JacksonRussett/UTAT_flightsystems/Test Board/Rough sketch - Aug 28.JPG

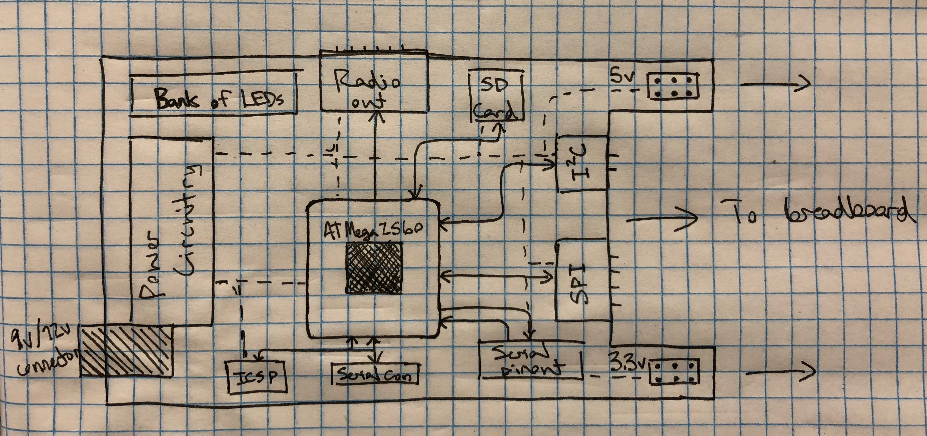
Test Board/Rough sketch - Aug 28.JPG
