JacksonRussett/UTAT_flightsystems/README.md

# UTAT_flightsystems

Github repository for the development of telemetry systems to be used in hybrid/solid rocket launches.
