JacksonRussett/UTAT_flightsystems/CAD/Avionics Bay/Avionics Bay June 2019/README.txt

Suffixes for the files:

function suffixes:
(part) - part to be integrated with another part to make the full printable version
(rep) - a CAD representation of a physical part of the bay that will not be printed
(assembly) - assembly of parts for visualization but not to print
<no suffix> - a final part version

printability suffixes:
(p) - printable and print ready
(nrtp) - will be printable but is currently not ready to print
(dnp) - do not print, not a printable file
