JacksonRussett/UTAT_flightsystems/CAD/MountingPlan_June2019.pptx

0.188’’

5.12’’

0.188’’

0.201’’

1.80’’

0.370’’

0.811’’

Radio Mount

StratoLogger Mount

0.654’’

2.76’’

PCB Mount

1.97’’

1.69’’

0.469’’

0.654’’

0.370’’

0.201’’

1.89’’
