JacksonRussett/UTAT_flightsystems/PCB/BlockDiagram_v1.pptx

To recovery
system actuation

Stratologgers

To radio
transmitter

Main Bay v2.1 – Flight Systems Board
Flight critical recovery actuation accomplished by flight computers (Stratologgers). All telemetry data (GPS, IMU, Pressure, and Stratologger info) collected and stored by microcontroller onto micro SD card.

Serial Devices

COMP2

COMP1

Reset
Button

Serial
Programmer

Sensors

Inertial Measurement Unit

Barometric Pressure Sensor

Two Wire interface

Storage

uSD Card Slot

SPI interface

Microcontroller
(ATMega2560 Breakout)

Serial Interface

Neo-6M GPS Module
