JacksonRussett/UTAT_flightsystems/PCB/MainBay_v2.2/Schematics/MicrocontrollerBase.pdf

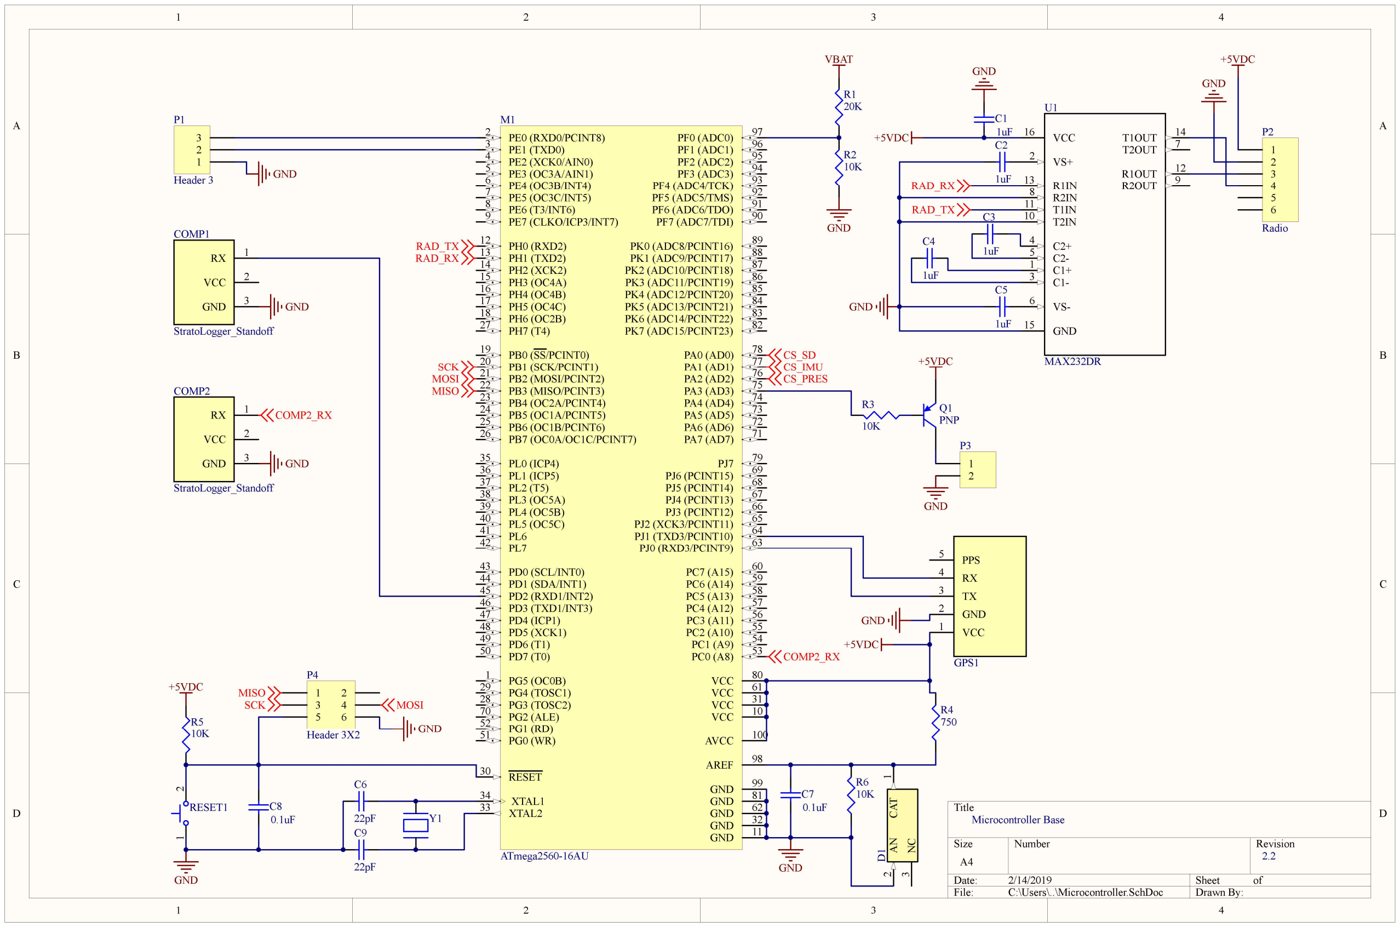
[picture p3: page 1]

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
Title

Size | Number | | Revision
A4
Date: | 2/14/2019 | Sheet | of
File: | C:\Users\..\Microcontroller.SchDoc | Drawn By:
PJ0 (RXD3/PCINT9) | 63
AVCC | 100
VCC | 31
GND | 11 GND | 32
GND | 81

PG5 (OC0B) 1

PD2 (RXD1/INT2) 45

RESET 30

PA4 (AD4) | 74
PA7 (AD7) | 71
PA5 (AD5) | 73
VCC | 80

XTAL1 34

PC1 (A9) | 54 PC2 (A10) | 55 PC3 (A11) | 56 PC4 (A12) | 57 PC5 (A13) | 58
PJ5 (PCINT14) | 68 PJ6 (PCINT15) | 69
AREF | 98

PD1 (SDA/INT1) 44

PB6 (OC1B/PCINT6) 25

PD3 (TXD1/INT3) 46
PD4 (ICP1) 47
PD5 (XCK1) 48
PD6 (T1) 49
PD7 (T0) 50
PF1 (ADC1) | 96
PF2 (ADC2) | 95
PC0 (A8) | 53
PA3 (AD3) | 75
PF4 (ADC4/TCK) | 93
PF5 (ADC5/TMS) | 92
PF6 (ADC6/TDO) | 91
PF7 (ADC7/TDI) | 90
PG0 (WR) 51 | PG1 (RD) 52 | PG2 (ALE) 70
PA6 (AD6) | 72

PD0 (SCL/INT0) 43

PH2 (XCK2) 14

PL2 (T5) 37
PL3 (OC5A) 38
PL4 (OC5B) 39
PL5 (OC5C) 40
PL6 41

VCC 10

XTAL2 33

PG3 (TOSC2) 28

PB5 (OC1A/PCINT5) 24

PF3 (ADC3) | 94
PA1 (AD1) | 77
PA2 (AD2) | 76

PE4 (OC3B/INT4) 6
PE5 (OC3C/INT5) 7
PE6 (T3/INT6) 8
PE7 (CLKO/ICP3/INT7) 9
PJ3 (PCINT12) | 66
PK5 (ADC13/PCINT21) | 84 PK4 (ADC12/PCINT20) | 85 PK3 (ADC11/PCINT19) | 86

PB2 (MOSI/PCINT2) 21
PB3 (MISO/PCINT3) 22
PB4 (OC2A/PCINT4) 23
PA0 (AD0) | 78
GND | 99
PK2 (ADC10/PCINT18) | 87
PJ2 (XCK3/PCINT11) | 65
PJ1 (TXD3/PCINT10) | 64

PG4 (TOSC1) 29

PF0 (ADC0) 97

PE3 (OC3A/AIN1) 5

PE2 (XCK0/AIN0) 4

PE1 (TXD0) 3

PE0 (RXD0/PCINT8) 2

PB7 (OC0A/OC1C/PCINT7) 26

PB1 (SCK/PCINT1) 20 PB0 (SS/PCINT0) 19

PH1 (TXD2) 13

PJ7 | 79
PJ4 (PCINT13) | 67
GND | 62
VCC | 61

PL7 42

PH0 (RXD2) 12

PH3 (OC4A) 15
PH4 (OC4B) 16
PH5 (OC4C) 17
PH6 (OC2B) 18
PH7 (T4) 27 | PK6 (ADC14/PCINT22) | 83
PK1 (ADC9/PCINT17) | 88 PK0 (ADC8/PCINT16) | 89

PL0 (ICP4) 35

PK7 (ADC15/PCINT23) 82

PL1 (ICP5) 36

PC6 (A14) | 59 PC7 (A15) | 60

M1

ATmega2560-16AU ² ¹
RESET1

GND

10K

R5

GND

Microcontroller Base

2.2

22pF | Y1

C6

22pF

C9 | CAT

# 1 NC

### 3 AN

### 2 D1

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
VBAT

GND

GND

MOSI
MISO

SCK

GND

GND

VCC | 2
GND | 3
RX | 1

COMP1

StratoLogger_Standoff

VCC | 2
GND | 3
RX | 1

COMP2

StratoLogger_Standoff

VCC 1

GND 2

TX 3

RX 4

PPS 5

GPS1

+5VDC

GND

GND

+5VDC

CS_PRES

CS_IMU

0.1uF

C8

CS_SD

RAD_RX

RAD_TX

1
2
3
4
5
6

P2

Radio

R2OUT | 9
R1OUT | 12
T2OUT | 7
T1OUT | 14

GND 15

VS- 6

C1- 3

C1+ 1

C2- 5

C2+ 4

T2IN 10 | T1IN 11 | R2IN 8

R1IN 13

VS+ 2

VCC 16

U1

MAX232DR

+5VDC

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
RAD_TX

RAD_RX

COMP2_RX

COMP2_RX | Q1 PNP

1
2

P3

GND

+5VDC

10K

R3

+5VDC
SCK | MOSI

MISO

0.1uF

C7

1 2
3 4
5 6

P4

Header 3X2 | GND

1

2

3

P1

Header 3
