JacksonRussett/UTAT_flightsystems/PCB/MainBay_v2.2/Schematics/Sensors.pdf

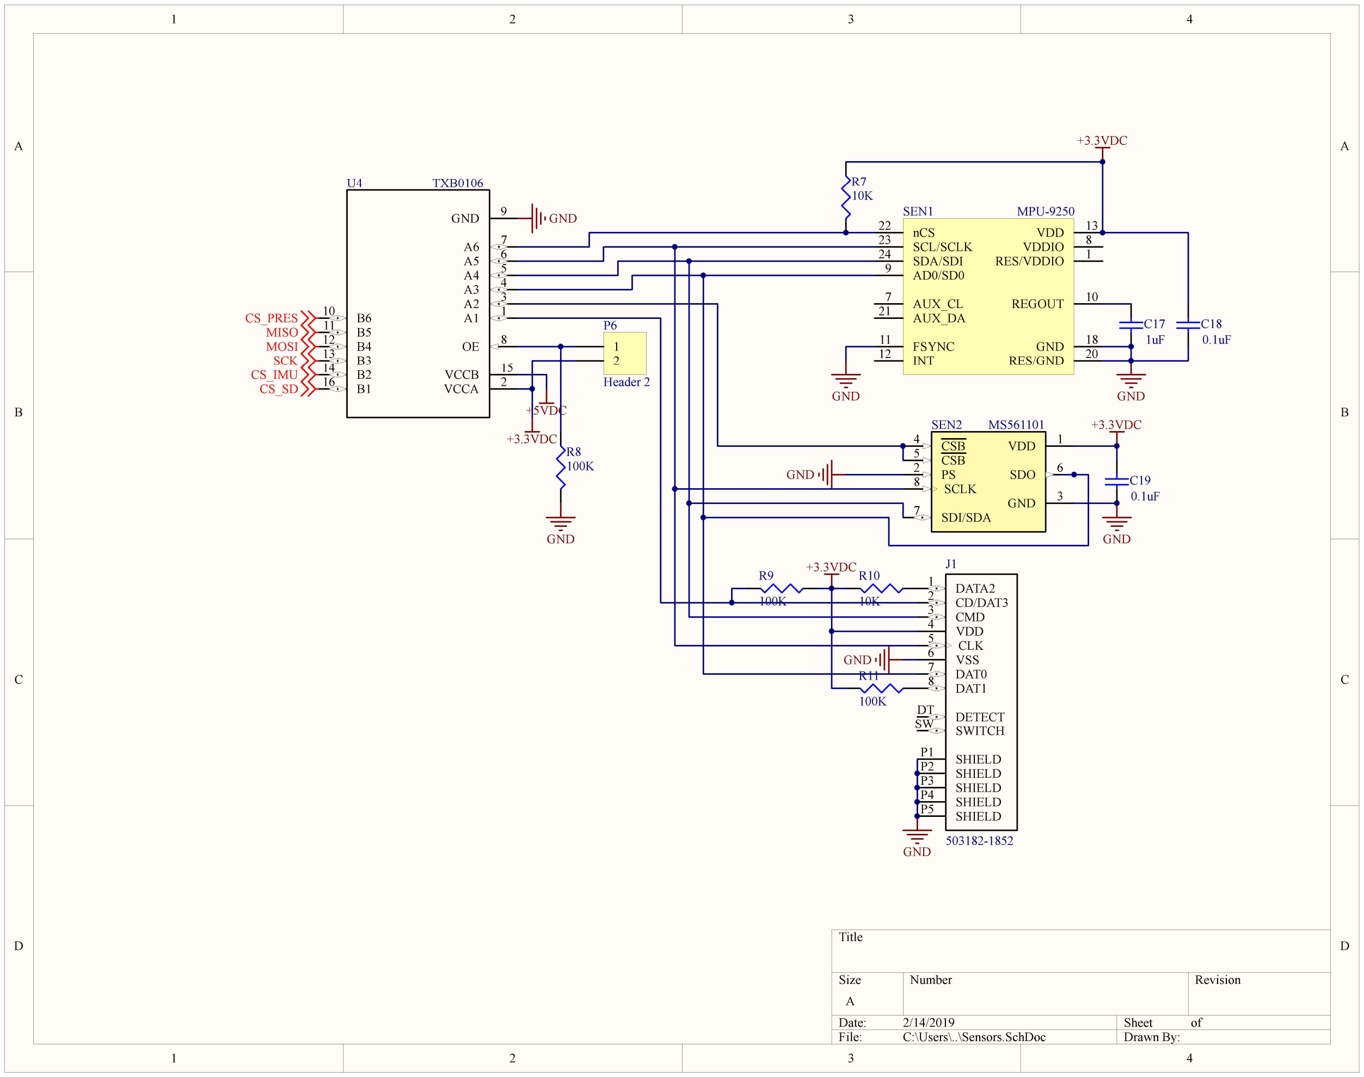
[picture p4: page 1]

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
Title

Size | Number | | Revision
A
Date: | 2/14/2019 | Sheet | of
File: | C:\Users\..\Sensors.SchDoc | Drawn By:
RES/VDDIO | 1

AUX_CL 7

VDDIO 8

AD0/SD0 9

REGOUT 10

FSYNC 11
INT 12
VDD | 13
GND | 18
RES/GND | 20

AUX_DA 21

nCS 22
SCL/SCLK 23
SDA/SDI 24
SEN1 | MPU-9250
GND | 3
SDO | 6
VDD | 1

SDI/SDA 7

SCLK 8

PS 2

CSB 5

CSB 4

SEN2 MS561101

+3.3VDC

GND

1uF

C17

GND

+3.3VDC

B6 10
B5 11
B4 12
B3 13
B2 14
B1 16
GND | 9
A6 | 7
A5 | 6
A4 | 5
A3 | 4
A2 | 3
A1 | 1
OE | 8
VCCB | 15
VCCA | 2
U4 | TXB0106

GND

+3.3VDC

GND
0.1uF

C19

SHIELD P5 | SHIELD P4 | SHIELD P3 | SHIELD P2 | SHIELD P1
SWITCH SW | DETECT DT

DAT1 8

DAT0 7

VSS 6

CLK 5

VDD 4

CMD 3

CD/DAT3 2

DATA2 1

J1

503182-1852

MOSI

MISO

CS_IMU

SCK

CS_PRES

GND

GND

GND

+3.3VDC

CS_SD

10K

R10

100K

R11

100K

R9

10K

R7

0.1uF

C18
1
2

P6

Header 2

+5VDC

100K

R8

GND
