JacksonRussett/UTAT_flightsystems/PCB/MainBay_v2.2/VoltRef.png

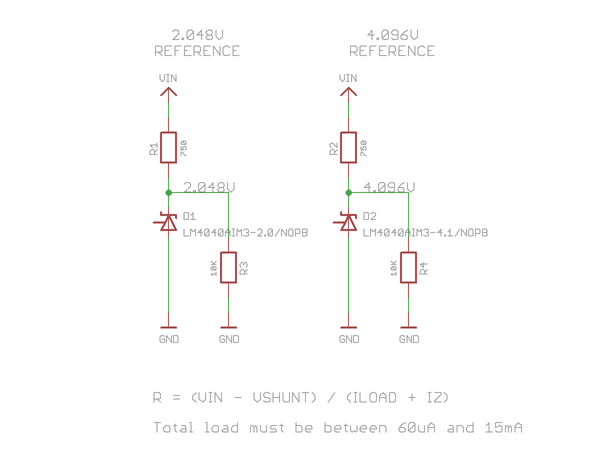
PCB/MainBay_v2.2/VoltRef.png
