JacksonRussett/UTAT_flightsystems/Reference Documents/PowerSchematic.PNG

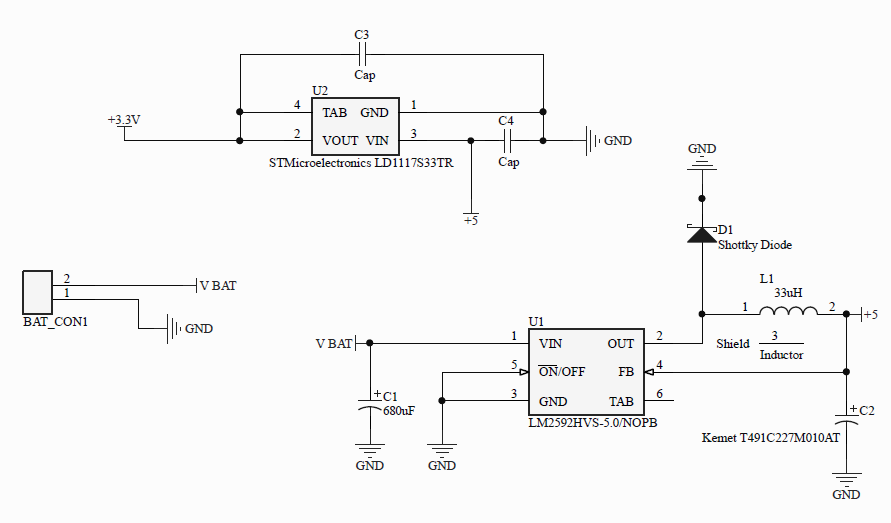
Reference Documents/PowerSchematic.PNG
