JacksonRussett/UTAT_flightsystems/PCB/Flight Systems Bill of Materials.xlsx

Sheet: v2.1
Flight Systems v2.1
Part Code | Class | Name | Details | Supplier | Weight (g) | 507.03 | Price: | $424.99 | Link
M1 | Active | Microcontroller | Arduino ATMega2560 "naked" | Fuzzystudios | 5.50 |  | $21.91 |  | https://www.tindie.com/products/FuzzyStudio/naked-mega-an-arduino-mega-2560-compatible-board/
COMP1 | Active | Flight Computer | Stratologger CF | Perfectflite | 25.60 |  | $93.10 |  | http://www.perfectflite.com/SLCF.html
COMP2 | Active | Flight Computer | Stratologger CF | Perfectflite | 25.60 |  | $93.10 |  | http://www.perfectflite.com/SLCF.html
SEN1 | Active | IMU Sensor | SparkFun IMU Breakout - MPU-9250 | Sparkfun | 0.99 |  | $18.40 |  | https://www.sparkfun.com/products/13762?_ga=2.125612810.101642581.1510585709-120728623.1510585709
SEN2 | Active | Pressure Transducer | CSG Shop - MS5611-01BA03 | CSG Shop | 0.56 |  | $29.99 |  | http://www.csgshop.com/product.php?id_product=96
MEM1 | Active | MicroSD Memory | MicroSD card breakout board+ | Sparkfun | 2.20 |  | $4.95 |  | https://www.sparkfun.com/products/13743
SD1 | Active | SD Card | SanDisk Micro SD | TBD | 0.50 |  | $22.59
BOARD | Active | PCB board | Flight Avionics Board | JLCBCB | 51.76 |  | Not included here |  | (weight estimate): https://www.leiton.de/leiton-tools-weight-calculation.html
GPS1 | Active | GPS Chip | Neo-6M GPS | Hobbyking | 13.00 |  | $38.45 |  | https://www.robotshop.com/en/u-blox-neo-6m-gps-receiver-module.html
CON1 | Connector | Recovery Connector | CONCR-140108 | Creatron Inc. | 5.00 |  | $7.50 |  | https://www.creatroninc.com/product/8-pin-circular-connector-set-panel-mount/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
USBTTL | External | USB to TTL Serial Converter | CP2102 USB 2.0 to TTL Serial Converter | Fuzzystudios | 0.00 |  | $5.35 |  | https://www.tindie.com/products/FuzzyStudio/cp2102-usb-20-to-ttl-serial-converter/
RADIO1 | External | Radio | RF4463PRO Radio Transmitter | Sketch AliExpress Vendor | 47.00 |  | Not included here |  | https://www.aliexpress.com/item/2pcs-SV652-433MHz-RS232-Interface-500mW-Industrial-Class-3km-Distance-Long-Distance-Wireless-Transceiver-Module/32391760503.ht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
BT1 | External | Main LiPo battery | 5000mAH 2S 15C | Pulse Battery | 217.00 |  | $41.59 |  | https://www.pulsebattery.com/pulse-5000mah-2s-7-4v-15c-receiver-battery-lipo-battery.html
BT2 | External | Battery | 9 volt | Walmart | 45.00 |  | Not included here
BT3 | External | Battery | 9 volt | Walmart | 45.00 |  | Not included here
SWITCH1 | External | RBF Switch | Subminiature Snap-Acting Switches | McMaster Carr | 6.20 |  | $5.97 |  | https://www.mcmaster.com/#catalog/124/965/=1c3z74q
SWITCH2 | External | RBF Switch | Subminiature Snap-Acting Switches | McMaster Carr | 6.20 |  | $5.97 |  | https://www.mcmaster.com/#catalog/124/965/=1c3z74q
SWITCH3 | External | RBF Switch | Subminiature Snap-Acting Switches | McMaster Carr | 6.20 |  | $5.97 |  | https://www.mcmaster.com/#catalog/124/965/=1c3z74q
C1 | Passive | Capacitor | 1uF Ceramic - 490-5860-1-ND | Digikey | 0.03 |  | $0.48 |  | https://www.digikey.ca/product-detail/en/murata-electronics-north-america/GRM31MR71E105KA01L/490-5860-1-ND/3029181
C2 | Passive | Capacitor | 100pF Ceramic - 490-4290-1-ND | Digikey | 0.03 |  | $0.52 |  | https://www.digikey.ca/product-detail/en/murata-electronics-north-america/GRM31A7U2J101JW31D/490-4290-1-ND/1022668
C3 | Passive | Capacitor | 680uF Electrolytic - P19725CT-ND | Digikey | 0.03 |  | $1.36 |  | https://www.digikey.ca/product-detail/en/panasonic-electronic-components/EEU-FM1V681B/P19725CT-ND/6109623
C4 | Passive | Capacitor | 10uF - 493-13313-1-ND | Digikey | 0.03 |  | $1.22 |  | https://www.digikey.ca/product-detail/en/nichicon/UCY2G100MPD1TD/493-13313-1-ND/4333047
C5 | Passive | Capacitor | 1uF Ceramic - 490-5860-1-ND | Digikey | 0.03 |  | $0.48 |  | https://www.digikey.ca/product-detail/en/murata-electronics-north-america/GRM31MR71E105KA01L/490-5860-1-ND/3029181
D1 | Passive | Diode | Shottky Diode - B140B-FDICT-ND | Digikey | 0.09 |  | $0.38 |  | https://www.digikey.ca/product-detail/en/diodes-incorporated/B140B-13-F/B140B-FDICT-ND/804889
L1 | Passive | Inductor | 33uH - 445-9568-1-ND | Digikey | 1.30 |  | $1.64 |  | https://www.digikey.ca/product-detail/en/tdk-corporation/CLF10040T-330M/445-9568-1-ND/3909741
R1 | Passive | Resistor | 10K Ohms - P10KDACT-ND | Digikey | 0.01 |  | $0.54 |  | https://www.digikey.ca/product-detail/en/panasonic-electronic-components/ERA-6AEB103V/P10KDACT-ND/1465971
R2 | Passive | Resistor | 1M Ohms - P1MDACT-ND | Digikey | 0.01 |  | $0.54 |  | https://www.digikey.ca/product-detail/en/panasonic-electronic-components/ERA-6AEB105V/P1MDACT-ND/1466019
R3 | Passive | Resistor | 100K Ohns - P100KDACT-ND | Digikey | 0.01 |  | $0.54 |  | https://www.digikey.ca/product-detail/en/panasonic-electronic-components/ERA-6AEB104V/P100KDACT-ND/1465995
R4 | Passive | Resistor | 1M Ohms - P1MDACT-ND | Digikey | 0.01 |  | $0.54 |  | https://www.digikey.ca/product-detail/en/panasonic-electronic-components/ERA-6AEB105V/P1MDACT-ND/1466019
R5 | Passive | Resistor | 100K Ohns - P100KDACT-ND | Digikey | 0.01 |  | $0.54 |  | https://www.digikey.ca/product-detail/en/panasonic-electronic-components/ERA-6AEB104V/P100KDACT-ND/1465995
RESET | Passive | Tactile Button | 401-1097-1-ND | Digikey | 0.12 |  | $1.03 |  | https://www.digikey.ca/product-detail/en/c-k/KSS221GLFS/401-1097-1-ND/417665
U1 | Passive | Buck Converter | LM2592HVSX-5.0/NOPBCT-ND | Digikey | 1.40 |  | $9.93 |  | https://www.digikey.ca/product-detail/en/texas-instruments/LM2592HVSX-5.0-NOPB/LM2592HVSX-5.0-NOPBCT-ND/3526872
U2 | Passive | Voltage Regulator | LD1117S33TR | Digikey | 0.60 |  | $9.53 |  | https://www.digikey.ca/product-detail/en/stmicroelectronics/LD1117S33TR/497-1242-1-ND/586242
Q1 | Passive | PNP Transistor for camera | ZXTP19020DFFCT-ND | Digikey | 0.01 |  | $0.88 |  | https://www.digikey.ca/product-detail/en/diodes-incorporated/ZXTP19020DFFTA/ZXTP19020DFFCT-ND/1557785

Sheet: v2.2
Flight Systems v2.2
Part Code | Class | Name | Details | Supplier | Weight (g) | 387.09 | Price: | $123.82 | Link
M1 | Active | Microcontroller | Arduino ATMega2560-16AU | Digikey |  |  | $18.62
COMP1 | Active | Flight Computer | Stratologger CF | Perfectflite | 25.60 |  | Already Bought |  | http://www.perfectflite.com/SLCF.html | http://www.perfectflite.com/SLCF.html | http://www.perfectflite.com/SLCF.html | http://www.perfectflite.com/SLCF.html | http://www.perfectflite.com/SLCF.html | http://www.perfectflite.com/SLCF.html | http://www.perfectflite.com/SLCF.html
COMP2 | Active | Flight Computer | Stratologger CF | Perfectflite | 25.60 |  | Already Bought |  | http://www.perfectflite.com/SLCF.html | http://www.perfectflite.com/SLCF.html | http://www.perfectflite.com/SLCF.html | http://www.perfectflite.com/SLCF.html | http://www.perfectflite.com/SLCF.html | http://www.perfectflite.com/SLCF.html | http://www.perfectflite.com/SLCF.html
SEN1 | Active | IMU Sensor | MPU-9250 | Mouser |  |  | $12.86 |  | https://www.mouser.ca/ProductDetail/TDK-InvenSense/MPU-9250
SEN2 | Active | Pressure Transducer | MS5611-01BA03 | Digikey |  |  | $18.82
SD1 | Active | MicroSD Memory | MicroSD card Slot | Mouser |  |  | $4.46 |  | https://www.mouser.ca/ProductDetail/Molex/503182-1853
- | Active | SD Card | SanDisk Micro SD |  |  |  | Already Bought
BOARD | Active | PCB board | Flight Avionics Board | JLCBCB | 51.76
GPS1 | Active | GPS Chip | Neo-6M GPS | Hobbyking | 13.00 |  | $38.45
CON1 | Connector | Recovery Connector | CONCR-140108 | Creatron Inc. | 5.00 |  | Already Bought
USBTTL | External | USB to TTL Serial Converter | CP2102 USB 2.0 to TTL Serial Converter | Fuzzystudios | 0.00 |  | Already Bought
RADIO1 | External | Radio | RF4463PRO Radio Transmitter | Sketch AliExpress Vendor | 47.00 |  | Already Bought
BT1 | External | Main LiPo battery | 5000mAH 2S 15C | Pulse Battery | 217.00 |  | Already Bought
SWITCH1 | External | RBF Switch | Subminiature Snap-Acting Switches | Mouser |  |  | $2.53 |  | https://www.mouser.ca/ProductDetail/Omron-Electronics/SS-5GL13?qs=nNiD76Ca0%252bv0XsO8fhViMQ==
SWITCH2 | External | RBF Switch | Subminiature Snap-Acting Switches | Mouser |  |  | $2.53 |  | https://www.mouser.ca/ProductDetail/Omron-Electronics/SS-5GL13?qs=nNiD76Ca0%252bv0XsO8fhViMQ==
SWITCH3 | External | RBF Switch | Subminiature Snap-Acting Switches | Mouser |  |  | $2.53 |  | https://www.mouser.ca/ProductDetail/Omron-Electronics/SS-5GL13?qs=nNiD76Ca0%252bv0XsO8fhViMQ==
RESET | Passive | Tactile Button | 401-1097-1-ND | Digikey | 0.12 |  | $1.03 |  | https://www.digikey.ca/product-detail/en/c-k/KSS221GLFS/401-1097-1-ND/417665
U1 | Active | Buck Converter | LM2592HVSX-5.0/NOPBCT-ND | Digikey | 1.40 |  | $9.93 |  | https://www.digikey.ca/product-detail/en/texas-instruments/LM2592HVSX-5.0-NOPB/LM2592HVSX-5.0-NOPBCT-ND/3526872
U2 | Active | Voltage Regulator | LD1117S33TR | Digikey | 0.60 |  | $9.53 |  | https://www.digikey.ca/product-detail/en/stmicroelectronics/LD1117S33TR/497-1242-1-ND/586242
U3 | Passive | Level SHifting | TXB0106 | Digikey
Q1 | Passive | PNP Transistor for camera | ZXTP19020DFFCT-ND | Digikey | 0.01 |  | $0.88 |  | https://www.digikey.ca/product-detail/en/diodes-incorporated/ZXTP19020DFFTA/ZXTP19020DFFCT-ND/1557785
C3 | Passive | Capacitor | 680uF Electrolytic | Home Hardware
C4 | Passive | Capacitor | 10uF Electrolytic | Home Hardware
BAT1 | Connector | XT30 battery connector |  | AliExpress |  |  | $1.65 |  | https://www.aliexpress.com/item/2Pairs-AMASS-XT30PW-Banana-golden-XT30-Upgrade-Right-Angle-Plug-Connector-male-female-ESC-Motor-PCB/32910350989.html

Sheet: Power Supply v1
Power Supply v1
Part Code | Class | Name | Details | Supplier | Weight (g) | 3.58 | Quantity | Price: | $62.53 | Links
U1 | Active | Buck Converter | Fixed 5 Volts - LM2592HVSX-5.0/NOPBCT-ND | Digikey | 1.40 |  | 2 | $19.86 |  | https://www.digikey.ca/product-detail/en/texas-instruments/LM2592HVSX-5.0-NOPB/LM2592HVSX-5.0-NOPBCT-ND/3526872
U2 | Active | Voltage Regulator | Fixed 3.3 Volts - LD1117S33TR | Digikey | 0.60 |  | 2 | $19.06 |  | https://www.digikey.ca/product-detail/en/stmicroelectronics/LD1117S33TR/497-1242-1-ND/586242
L1 | Passive | Inductor | 33uH - 445-9568-1-ND | Digikey | 1.30 |  | 5 | $8.20 |  | https://www.digikey.ca/product-detail/en/tdk-corporation/CLF10040T-330M/445-9568-1-ND/3909741
D1 | Passive | Diode | Shottky Diode - B140B-FDICT-ND | Digikey | 0.09 |  | 5 | $1.90 |  | https://www.digikey.ca/product-detail/en/diodes-incorporated/B140B-13-F/B140B-FDICT-ND/804889
?1 | Passive | Fuse | Glass Fuse (5A) - 5MF 5-R | Digikey | 0.09 |  | 5 | $0.21 |  | https://www.digikey.com/product-detail/en/bel-fuse-inc/5MF-5-R/507-1269-ND/1009041
?1 | Mount | Fuse | Fuse Holders - 01110501Z | Digikey | 0.10 |  | 10 | $1.90 |  | https://www.digikey.ca/product-detail/en/littelfuse-inc/01110501Z/F4189-ND/2518598
U3 | Active | Comparator | TPS3700DDCR | Digikey |  |  | 4 | $11.40 |  | https://www.digikey.ca/product-detail/en/texas-instruments/TPS3700DDCR/296-30395-1-ND/3250123
