JacksonRussett/UTAT_flightsystems/CAD/Avionics Bay/Avionics Bay June 2019/Frame/Frame.SLDPRT

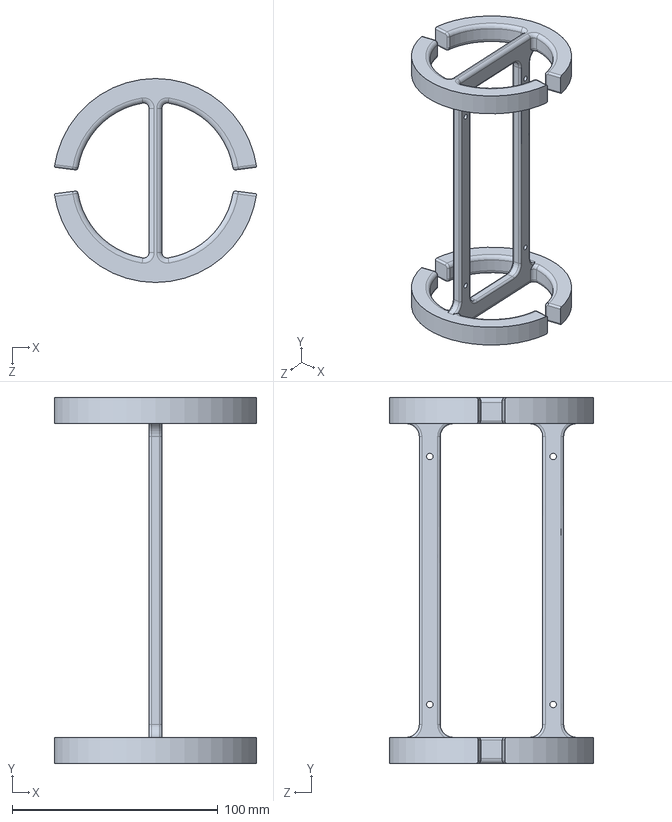
[picture p7: CAD file, 2019-06-23]
CAD/Avionics Bay/Avionics Bay June 2019/Frame/Frame.SLDPRT
98.2 x 177.8 x 99.1 mm
