JacksonRussett/UTAT_flightsystems/CAD/Avionics Bay/Avionics Bay June 2019/Radio/Radio_Mount.SLDPRT

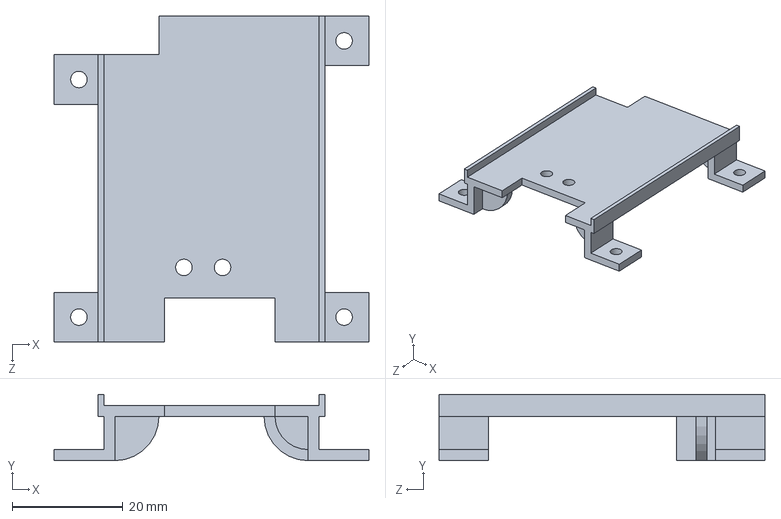
[picture p8: CAD file, 2019-06-23]
CAD/Avionics Bay/Avionics Bay June 2019/Radio/Radio_Mount.SLDPRT
57.0 x 12.0 x 59.0 mm
