JacksonRussett/UTAT_flightsystems/CAD/Avionics Bay/Avionics Bay June 2019/20190406_AvionicsFramePlate (assembly) (dnp).SLDASM

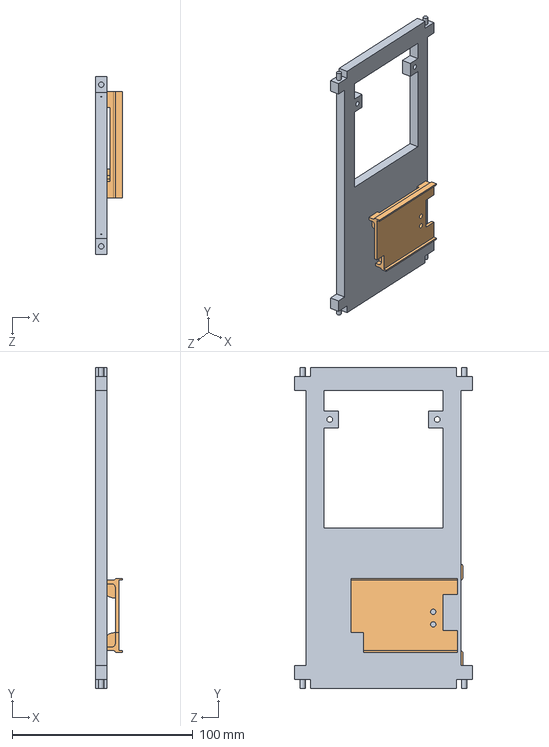
[picture p9: CAD file, 2019-06-23]
CAD/Avionics Bay/Avionics Bay June 2019/20190406_AvionicsFramePlate (assembly) (dnp).SLDASM
15.0 x 177.8 x 98.9 mm
20190312_AvionicsFramePlate (part) (dnp)
20190330_RadioMount (nrtp)
