JacksonRussett/UTAT_flightsystems/CAD/Avionics Bay/Avionics Bay June 2019/20190406_AvionicsFrameBasesRBF (assembly) (dnp).SLDASM

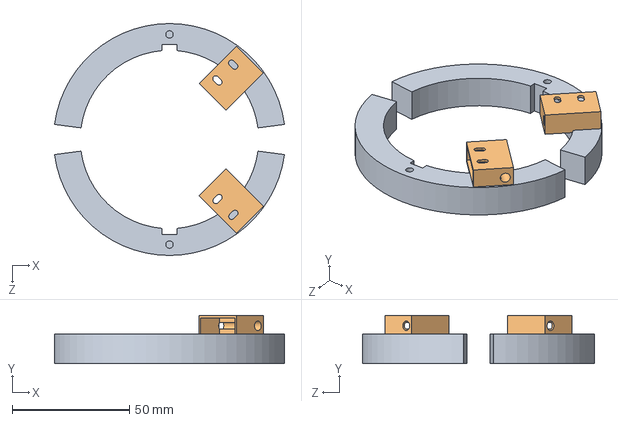
[picture p10: CAD file, 2019-06-23]
CAD/Avionics Bay/Avionics Bay June 2019/20190406_AvionicsFrameBasesRBF (assembly) (dnp).SLDASM
98.2 x 20.6 x 99.0 mm
20190330_AvionicsFrameBases (nrtp) x 2
20190312_RBFHolder (part) (dnp) x 2
