JacksonRussett/UTAT_flightsystems/CAD/20190504_L2_Avionics_Rails-p.sldprt

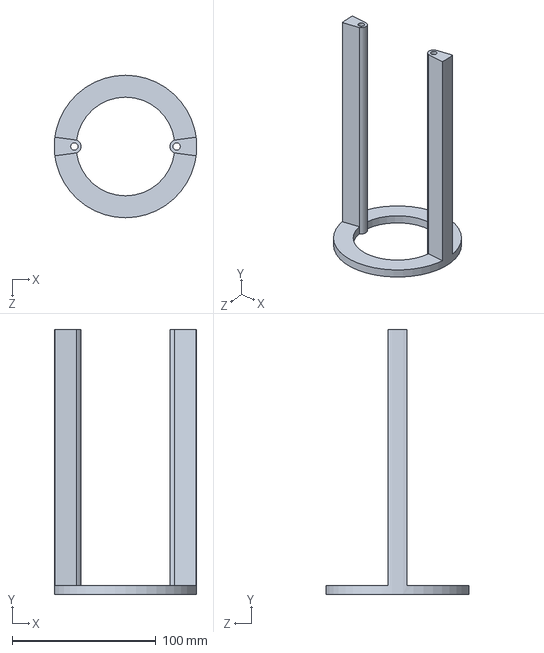
[picture p11: CAD file, 2019-06-23]
CAD/20190504_L2_Avionics_Rails-p.sldprt
98.8 x 184.1 x 99.1 mm
