JacksonRussett/UTAT_flightsystems/CAD/Avionics Bay/Avionics Bay June 2019/20180727_Avionics_frame2.STL

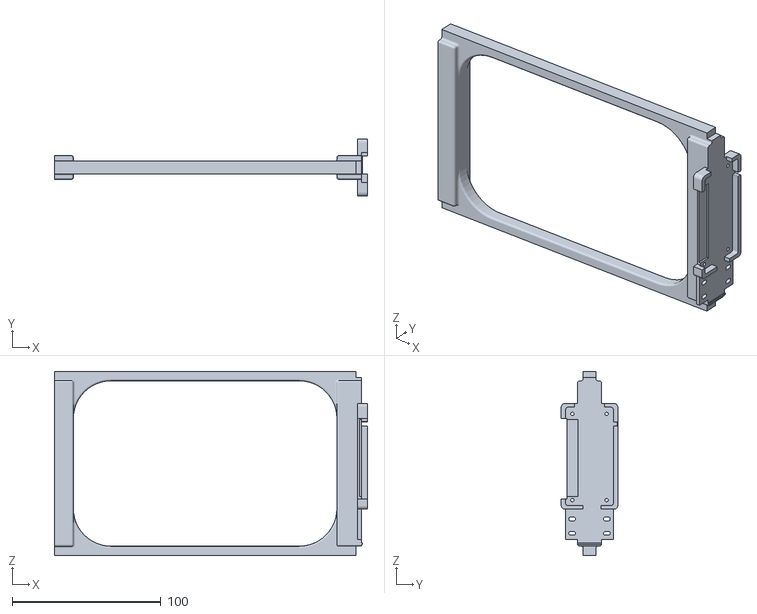
[picture p12: CAD file, 2019-06-23]
CAD/Avionics Bay/Avionics Bay June 2019/20180727_Avionics_frame2.STL
210.6 x 38.1 x 124.0
