JacksonRussett/UTAT_flightsystems/CAD/20190506_L2_AvionicsFramePlate-p.sldprt

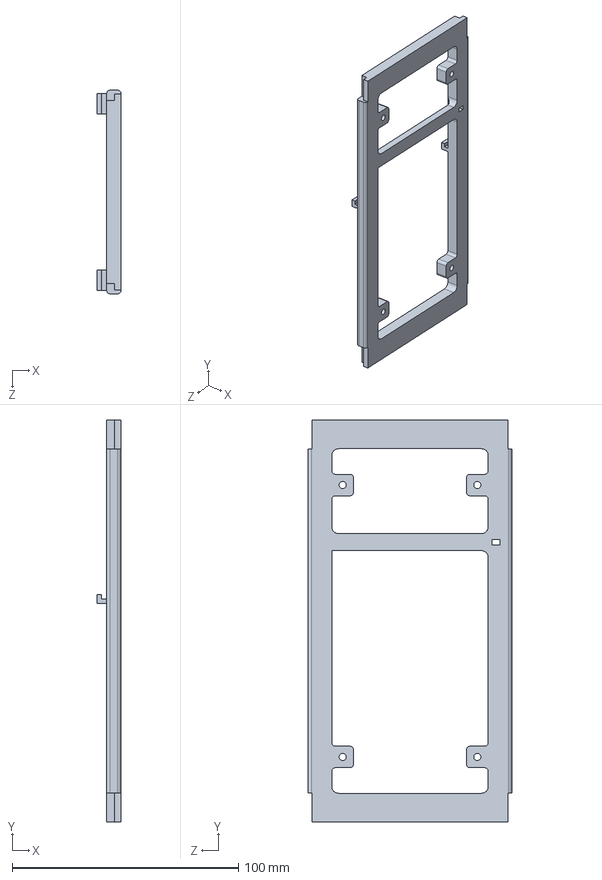
[picture p13: CAD file, 2019-06-23]
CAD/20190506_L2_AvionicsFramePlate-p.sldprt
10.6 x 177.8 x 90.1 mm
