JacksonRussett/UTAT_flightsystems/CAD/20190506_L2_AvionicsFrameBasesRBF-p.sldprt

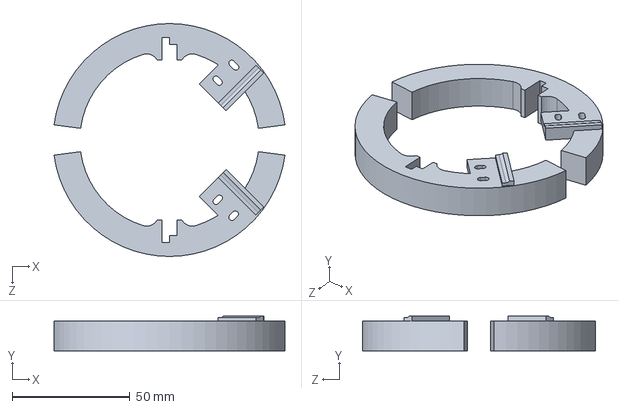
[picture p14: CAD file, 2019-06-23]
CAD/20190506_L2_AvionicsFrameBasesRBF-p.sldprt
98.2 x 14.7 x 99.0 mm
