JacksonRussett/UTAT_flightsystems/CAD/Avionics Bay/Avionics Bay June 2019/20190330_BatteryCrib (nrtp).SLDPRT

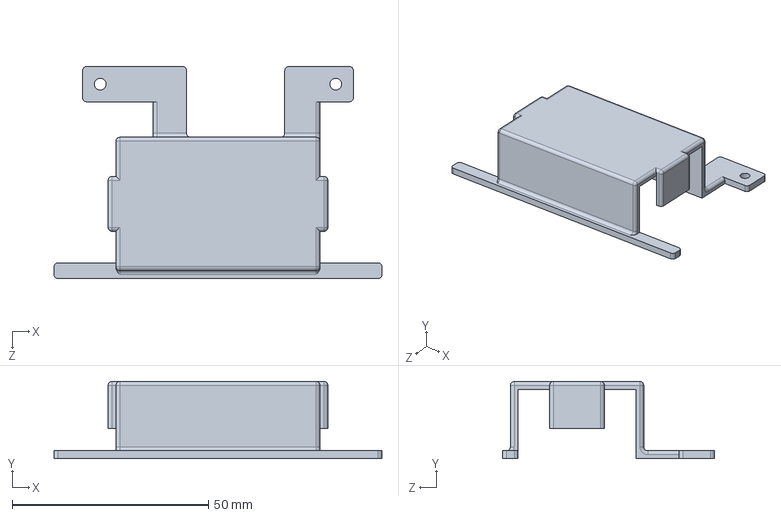
[picture p15: CAD file, 2019-06-23]
CAD/Avionics Bay/Avionics Bay June 2019/20190330_BatteryCrib (nrtp).SLDPRT
83.6 x 19.6 x 54.0 mm
