JacksonRussett/UTAT_flightsystems/CAD/Avionics Bay/Avionics Bay June 2019/20190406_AvionicsFrameBasesRBF (nrtp).SLDPRT

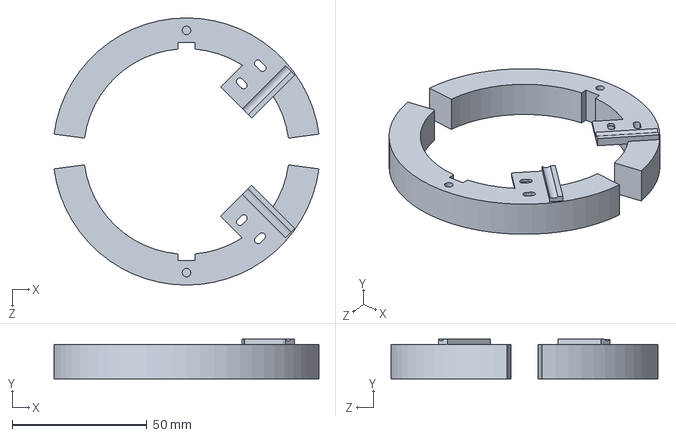
[picture p16: CAD file, 2019-06-23]
CAD/Avionics Bay/Avionics Bay June 2019/20190406_AvionicsFrameBasesRBF (nrtp).SLDPRT
98.2 x 14.7 x 99.0 mm
