JacksonRussett/UTAT_flightsystems/CAD/Avionics Bay/Avionics Bay June 2019/20190504_L2_AvionicsFramePlate (p).SLDPRT

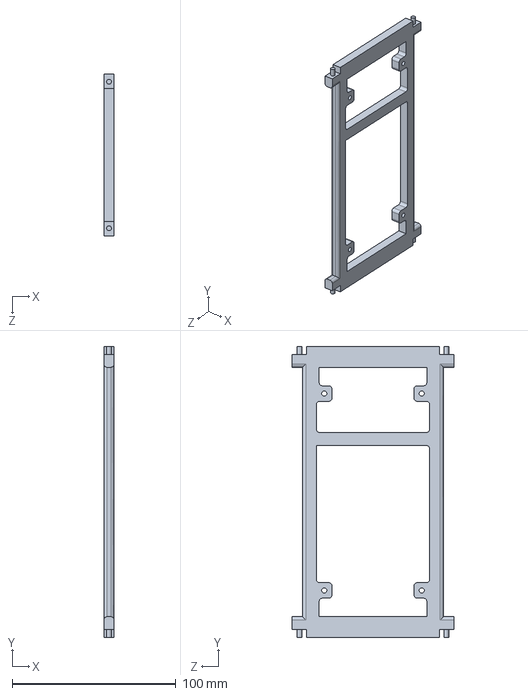
[picture p17: CAD file, 2019-06-23]
CAD/Avionics Bay/Avionics Bay June 2019/20190504_L2_AvionicsFramePlate (p).SLDPRT
6.35 x 177.8 x 99.0 mm
