JacksonRussett/UTAT_flightsystems/CAD/Avionics Bay/Avionics Bay June 2019/20190330_AvionicsFrameBases (nrtp).SLDPRT

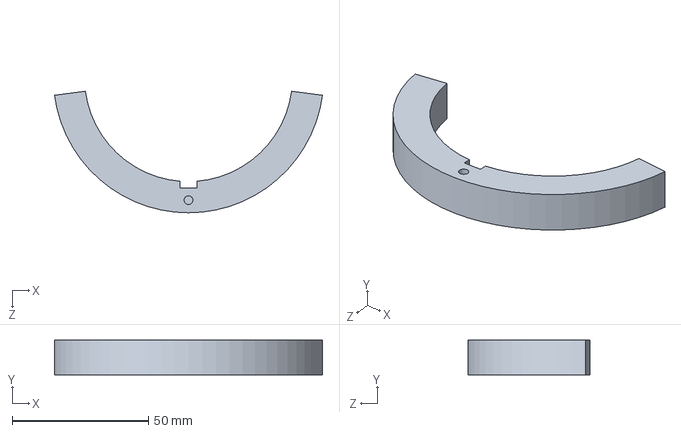
[picture p18: CAD file, 2019-06-23]
CAD/Avionics Bay/Avionics Bay June 2019/20190330_AvionicsFrameBases (nrtp).SLDPRT
98.2 x 12.7 x 44.6 mm
