JacksonRussett/UTAT_flightsystems/CAD/Avionics Bay/Avionics Bay June 2019/20190406_AvionicsFramePlate (nrtp).SLDPRT

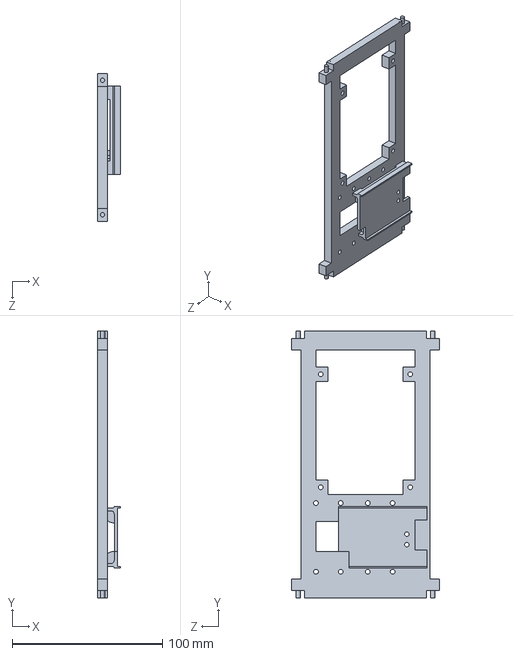
[picture p19: CAD file, 2019-06-23]
CAD/Avionics Bay/Avionics Bay June 2019/20190406_AvionicsFramePlate (nrtp).SLDPRT
15.0 x 177.8 x 98.9 mm
