JacksonRussett/UTAT_flightsystems/CAD/Avionics Bay/Avionics Bay June 2019/20190312_Radio (rep) (dnp).SLDPRT

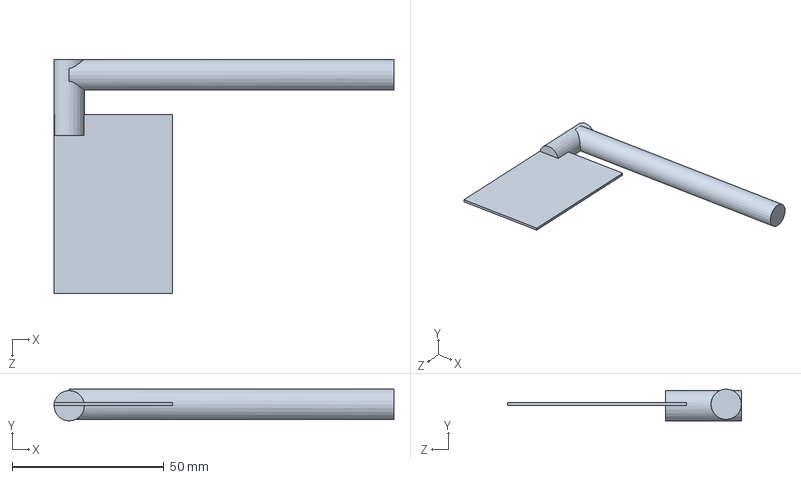
[picture p20: CAD file, 2019-06-23]
CAD/Avionics Bay/Avionics Bay June 2019/20190312_Radio (rep) (dnp).SLDPRT
112.0 x 10.5 x 77.0 mm
