JacksonRussett/UTAT_flightsystems/CAD/Avionics Bay/Avionics Bay June 2019/20190316_StratoLoggers.SLDPRT

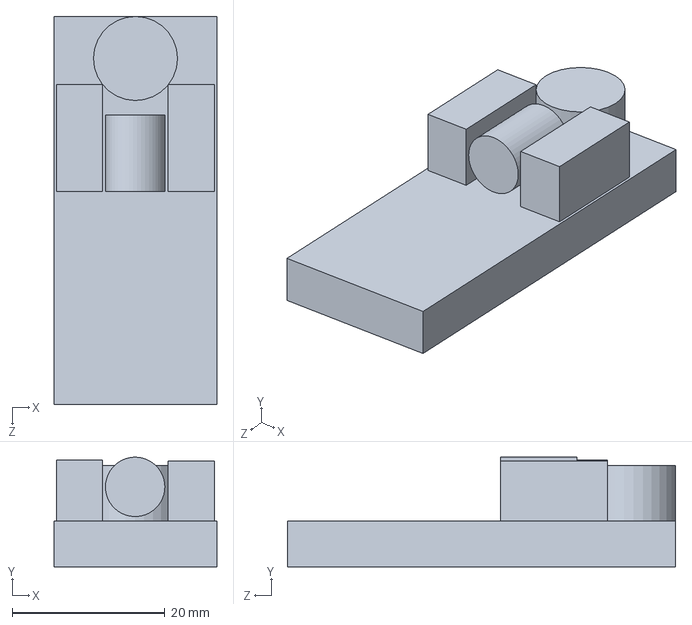
[picture p21: CAD file, 2019-06-23]
CAD/Avionics Bay/Avionics Bay June 2019/20190316_StratoLoggers.SLDPRT
21.3 x 14.3 x 50.8 mm
