JacksonRussett/UTAT_flightsystems/CAD/Avionics Bay/Avionics Bay June 2019/20190312_AvionicsFramePlate (part) (dnp).SLDPRT

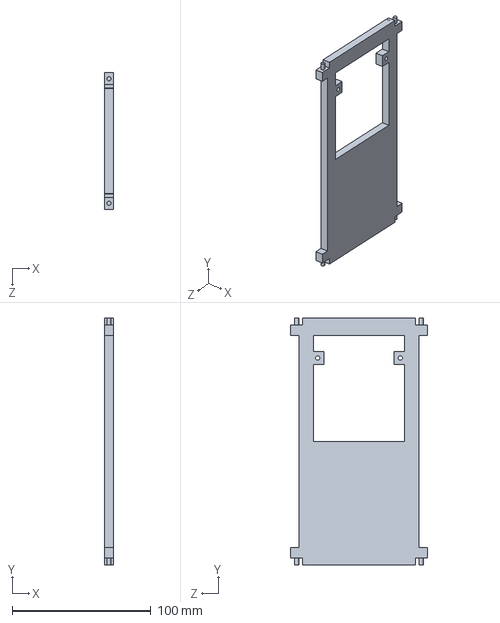
[picture p22: CAD file, 2019-06-23]
CAD/Avionics Bay/Avionics Bay June 2019/20190312_AvionicsFramePlate (part) (dnp).SLDPRT
6.35 x 177.8 x 98.9 mm
