JacksonRussett/UTAT_flightsystems/CAD/Avionics Bay/Avionics Bay June 2019/20190312_RBFHolder (part) (dnp).SLDPRT

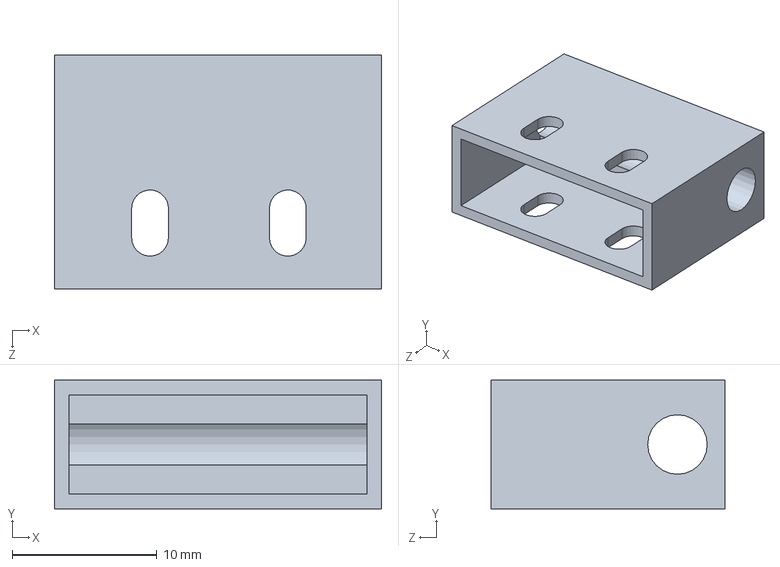
[picture p23: CAD file, 2019-06-23]
CAD/Avionics Bay/Avionics Bay June 2019/20190312_RBFHolder (part) (dnp).SLDPRT
22.6 x 8.89 x 16.2 mm
