JacksonRussett/UTAT_flightsystems/(list of files, cad)

Other CAD files:
CAD/Avionics Bay/Avionics Bay June 2019/20190330_RadioMount (nrtp).SLDPRT
CAD/Avionics Bay/Avionics Bay June 2019/20190504_L2_AvionicsFrameBasesRBF (p).SLDPRT
