JacksonRussett/UTAT_flightsystems/Test Board/Dev Board Dimensions.pptx

4mm

120mm

10mm

4mm

d = 4mm

16mm

56mm

36mm
