JacksonRussett/UTAT_flightsystems/Code/Flight Code/L2_Nov2019/test.csv

Time | Pressure | Temperatue | Altitude | Current | Voltage | AccelX | AccelY | AccelZ | GyroX | GyroY | GyroZ | Latitude | Longitude
14.082598 | 1023.700012 | 21.799999 | -88.376160 | 187.699997 | 7.390760 | -0.732663 | 10.257283 | 0.033521 | 0.032607 | 0.013588 | 0.005605 | nan | nan
8372580.000000 | 1023.609985 | 21.820000 | -87.625595 | 187.399994 | 7.391830 | -0.287319 | 10.367422 | 0.474076 | 0.052048 | -0.000527 | 0.040493 | nan | nan
8435081.000000 | 1023.530029 | 21.840000 | -86.958923 | 715.400024 | 7.258700 | -0.354360 | 10.319535 | 0.081407 | 0.047121 | -0.025828 | 0.042756 | nan | nan
8497581.000000 | 1023.479980 | 21.820000 | -86.532303 | 711.099976 | 7.238580 | -0.062252 | 10.300381 | 0.167603 | 0.024218 | -0.024896 | 0.047284 | nan | nan
8560081.000000 | 1023.530029 | 21.840000 | -86.958923 | 702.400024 | 7.254301 | 0.110139 | 10.314747 | -0.311262 | 0.060970 | -0.034350 | 0.051811 | nan | nan
8622581.000000 | 1023.609985 | 21.820000 | -87.625595 | 702.200012 | 7.243061 | -0.004789 | 10.309958 | -0.047886 | 0.006907 | -0.026893 | 0.040892 | nan | nan
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
