JacksonRussett/UTAT_flightsystems/Test Board/DevBoardDim.PNG

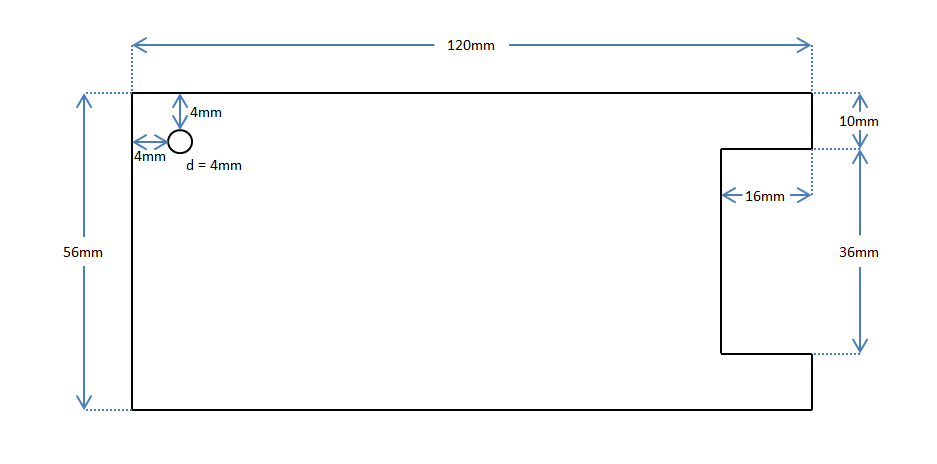
Test Board/DevBoardDim.PNG
