JacksonRussett/UTAT_flightsystems/Test Board/Power Unit.jpg

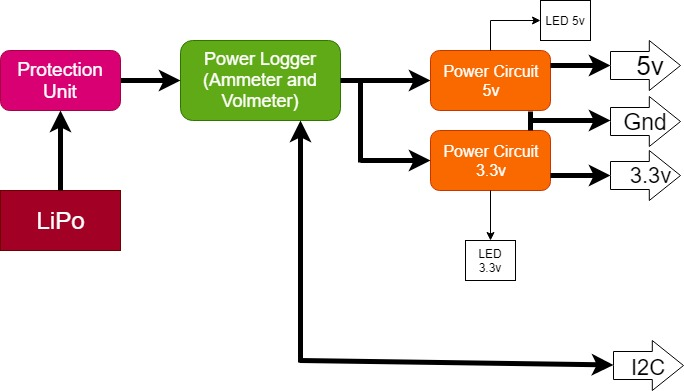
Test Board/Power Unit.jpg
