JacksonRussett/UTAT_flightsystems/Test Board/Testing System Avionics.jpg

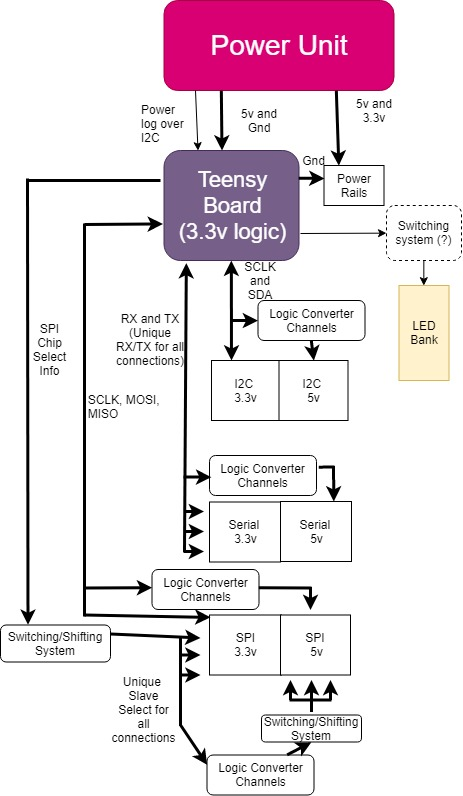
Test Board/Testing System Avionics.jpg
