JacksonRussett/UTAT_flightsystems/(threads)

Thread 1 (2019-06-28):

Redesign buck converter circuit

JacksonRussett, 2019-06-28:

Thread 4 (2019-06-28):

PCB Mount Design

JacksonRussett, 2019-06-28:

JacksonRussett, 2019-07-08:
To mount both PCBs we need to figure out how tall all of the parts are. This will require standoffs (probably M3).
