JacksonRussett/UTAT_flightsystems/Reference Documents/Main Bay v2.0 Schematic.pdf

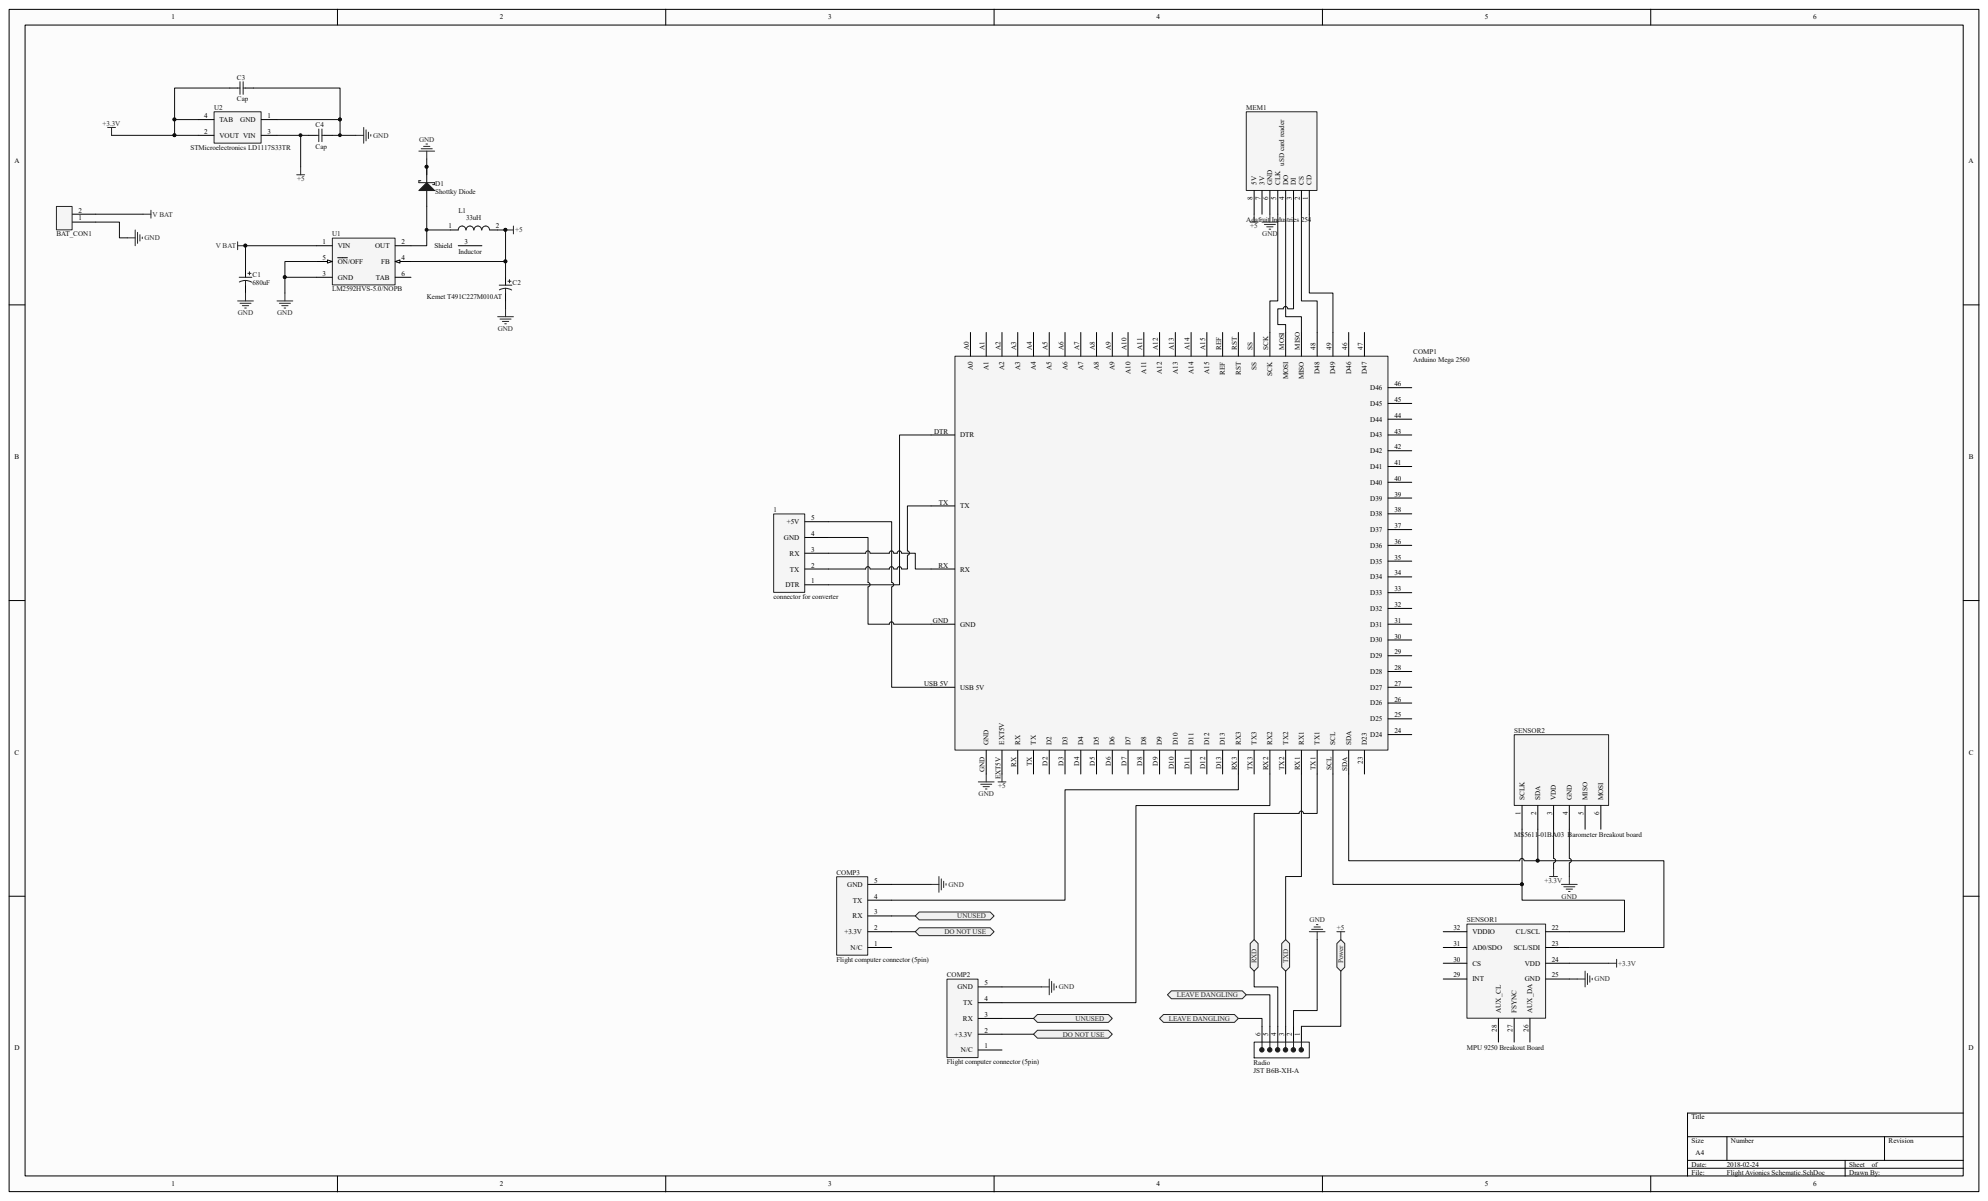
[picture p27: page 1]

MPU 9250 Breakout Board SCLK
