JacksonRussett/UTAT_flightsystems/PCB/MainBay_v2.2/Bluno Mega2560 Schematic.pdf

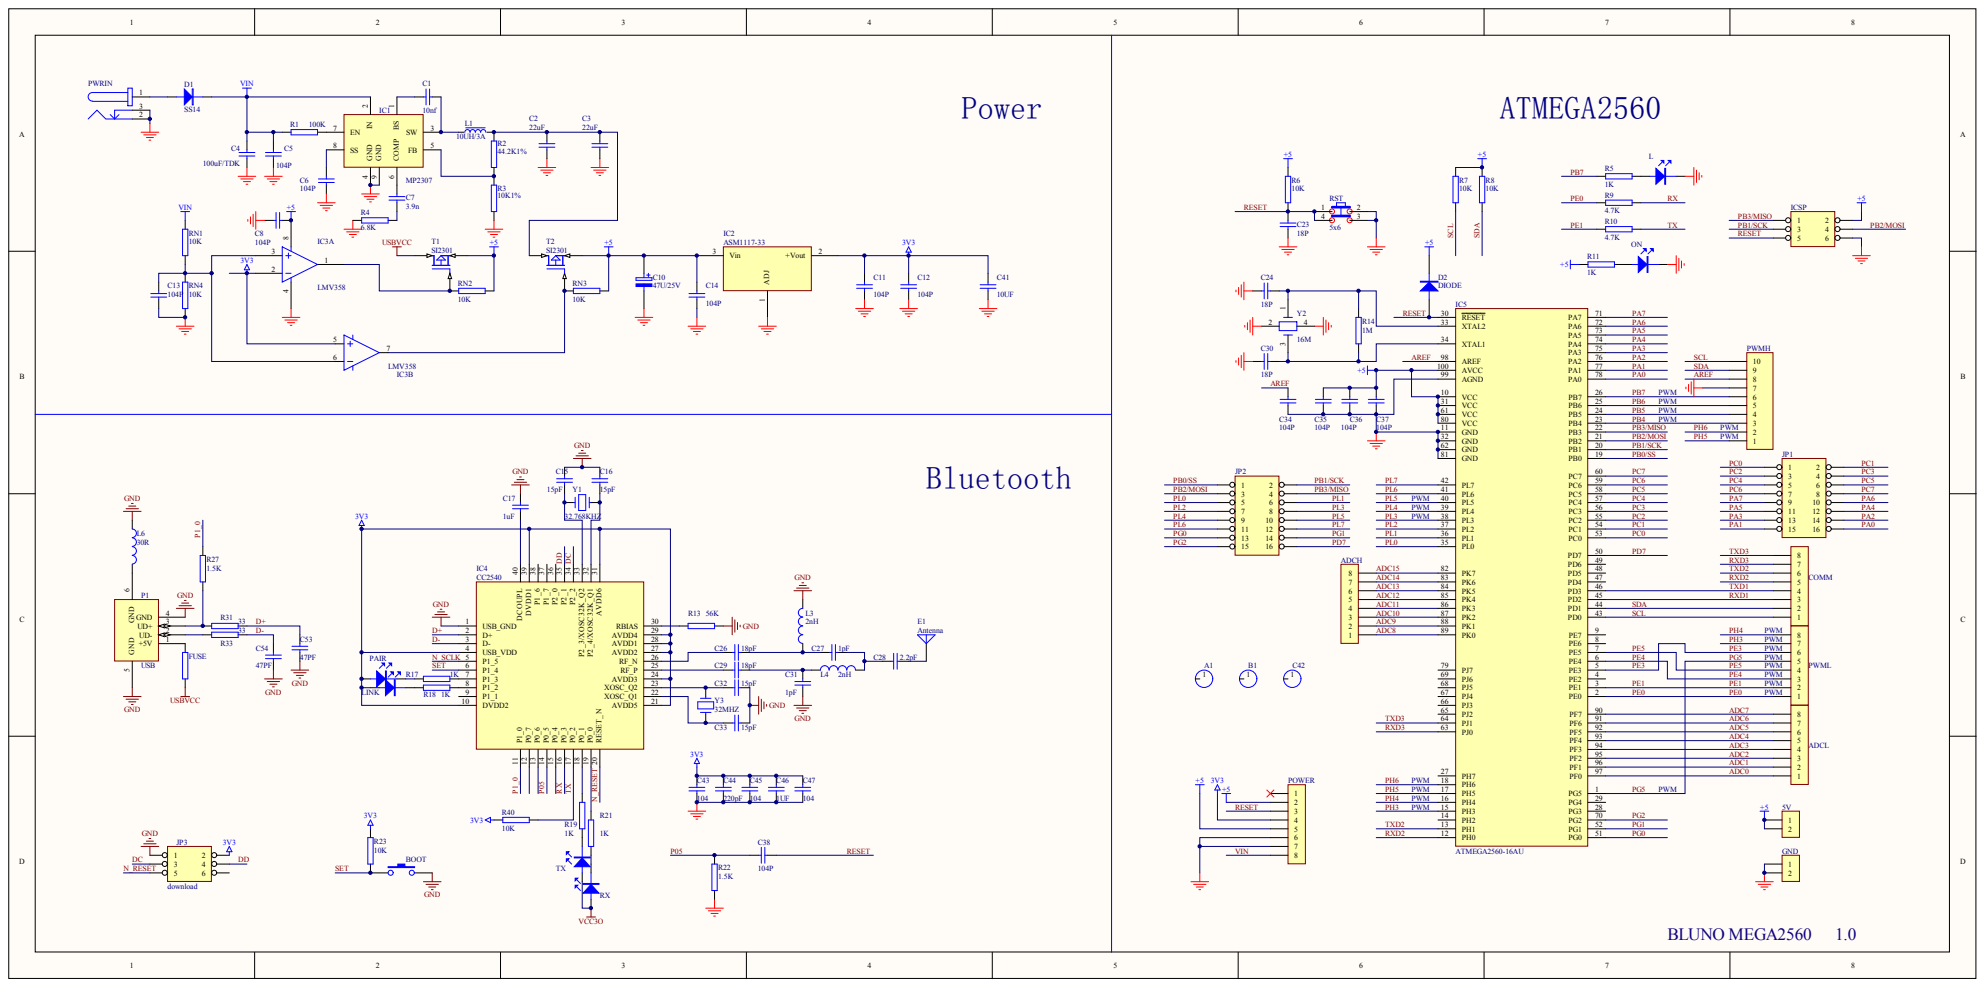
[picture p28: page 1]

PWRIN D1 VIN C1 | ATMEGA2560 +5 +5 L RESET 1 2 ICSP

1M | XTAL1 34 | PA5

VCC 10 | PB7 PWM
VCC 31 | PB6 PWM
VCC 61 | PB5 PWM

GND 11 | PB3/MISO PH6 PWM

GND 62 | PB1/SCK
GND 81 | PB0/SS

ADC3

1 2 3 4 5 6 7 8 | PH5 PWM | PH0 12 PH1 13 PH2 14 PH3 15 PH4 16 PH5 17 PH6 18 PH7 27

ADC1
ADC0

PG5 PWM | 5V

RESET | | PH4 PWM
