JacksonRussett/UTAT_flightsystems/Reference Documents/OpenLog_v15.pdf

## Power Circuit:

## SPI Header:

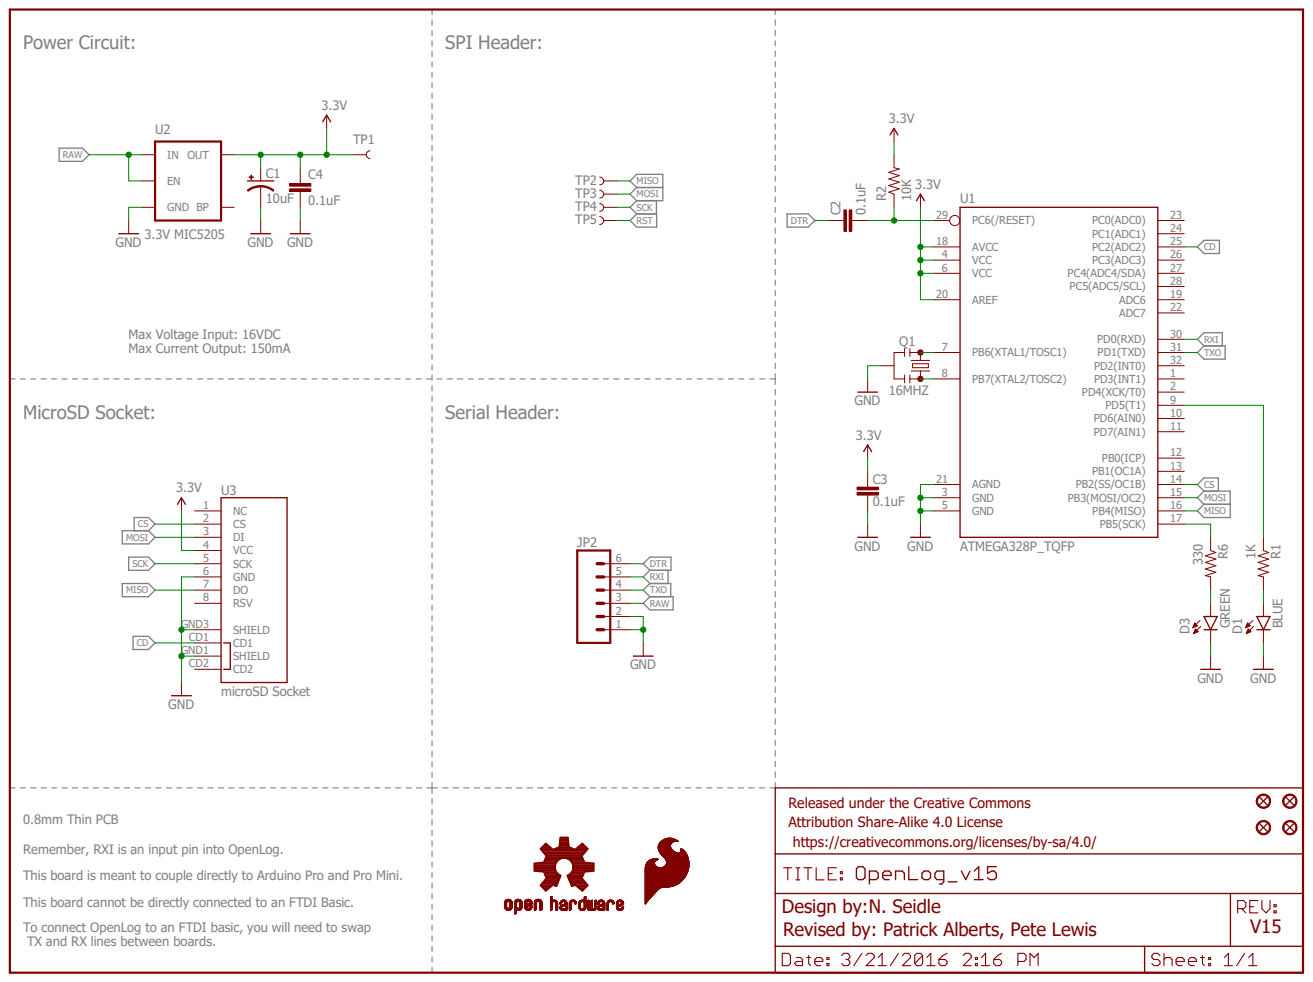
[picture p29: page 1]

Released under the Creative Commons
Attribution Share-Alike 4.0 License
https://creativecommons.org/licenses/by-sa/4.0/

Remember, RXI is an input pin into OpenLog.

This board is meant to couple directly to Arduino Pro and Pro Mini.

This board cannot be directly connected to an FTDI Basic.

Design by:
Revised by: Patrick Alberts, Pete Lewis

To connect OpenLog to an FTDI basic, you will need to swap
TX and RX lines between boards.
