JacksonRussett/UTAT_flightsystems/PCB/MainBay_v2.2/Schematics/PowerSystem.pdf

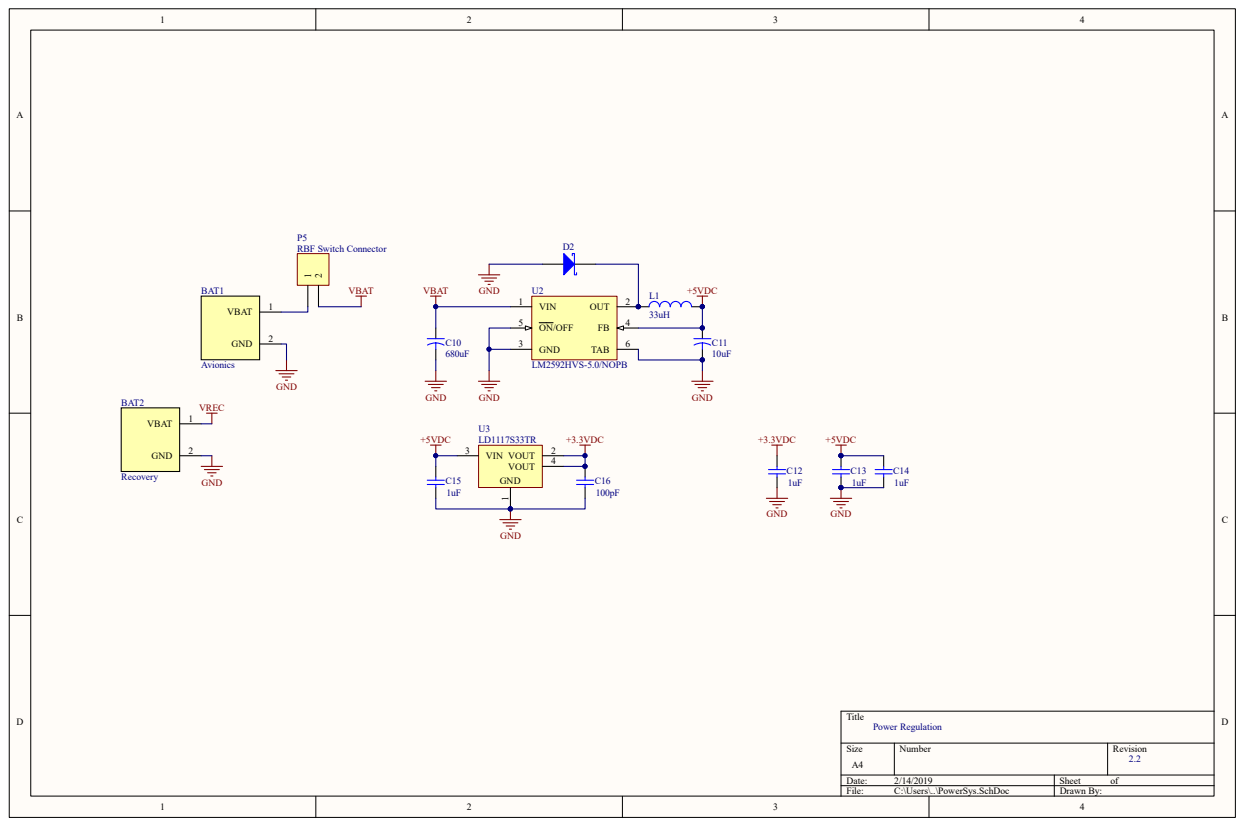
[picture p30: page 1]
