JacksonRussett/UTAT_flightsystems/(list of files, drawings)

Other design files:
PCB/Altium Libraries/Breakout Library/PcbLib1.PcbLib
PCB/Altium Libraries/Breakout Library/Schlib1.SchLib
PCB/Altium Libraries/Custom Component Library/CustomComp.PcbLib
PCB/Altium Libraries/Custom Component Library/CustomComp.SchLib
PCB/Altium Libraries/Custom Component Library/Imported 503182-1852.lia/503182-1852.PcbLib
PCB/Altium Libraries/Custom Component Library/Imported 503182-1852.lia/503182-1852.SchLib
PCB/Altium Libraries/Custom Component Library/Imported ATMEGA2560-16AU.lia/ATMEGA2560-16AU.PcbLib
PCB/Altium Libraries/Custom Component Library/Imported ATMEGA2560-16AU.lia/ATMEGA2560-16AU.SchLib
PCB/Altium Libraries/Custom Component Library/Imported CAPAE430X550N.lia/CAPAE430X550N.PcbLib
PCB/Altium Libraries/Custom Component Library/Imported CAPAE430X550N.lia/CAPAE430X550N.SchLib
PCB/Altium Libraries/Custom Component Library/Imported IRF540NPBF.lia/IRF540NPBF.PcbLib
PCB/Altium Libraries/Custom Component Library/Imported IRF540NPBF.lia/IRF540NPBF.SchLib
PCB/Altium Libraries/Custom Component Library/Imported Libs/Imported LM4040A82IDBZR.lia/LM4040A82IDBZR.PcbLib
PCB/Altium Libraries/Custom Component Library/Imported Libs/Imported LM4040A82IDBZR.lia/LM4040A82IDBZR.SchLib
PCB/Altium Libraries/Custom Component Library/Imported MAX232DR.lia/MAX232DR.PcbLib
PCB/Altium Libraries/Custom Component Library/Imported MAX232DR.lia/MAX232DR.SchLib
PCB/Altium Libraries/Custom Component Library/Imported MS561101BA03-50.lia/MS561101BA03-50.PcbLib
PCB/Altium Libraries/Custom Component Library/Imported MS561101BA03-50.lia/MS561101BA03-50.SchLib
PCB/Altium Libraries/Custom Component Library/Imported TXB0104PWR.lia/TXB0104PWR.PcbLib
PCB/Altium Libraries/Custom Component Library/Imported TXB0104PWR.lia/TXB0104PWR.SchLib
PCB/Altium Libraries/Custom Component Library/Imported TXB0106PWR.lia/TXB0106PWR.PcbLib
PCB/Altium Libraries/Custom Component Library/Imported TXB0106PWR.lia/TXB0106PWR.SchLib
PCB/Altium Libraries/Custom Component Library/Imported ZTT-16.00MX.lia/ZTT-16.00MX.PcbLib
PCB/Altium Libraries/Custom Component Library/Imported ZTT-16.00MX.lia/ZTT-16.00MX.SchLib
PCB/Altium Libraries/Custom Component Library/MPU-9250.PcbLib
PCB/Altium Libraries/Custom Component Library/MPU-9250.SchLib
PCB/Altium Libraries/Imported 1201M2S3AQE2.lia/1201M2S3AQE2.PcbLib
PCB/Altium Libraries/Imported 1201M2S3AQE2.lia/1201M2S3AQE2.SchLib
PCB/Altium Libraries/Imported (1) Common-Parts-Library.lia/Common-Parts-Library.PcbLib
PCB/Altium Libraries/Imported (1) Common-Parts-Library.lia/Common-Parts-Library.SchLib
PCB/Altium Libraries/Imported Common-Parts-Library.lia/Common-Parts-Library.PcbLib
PCB/Altium Libraries/Imported Common-Parts-Library.lia/Common-Parts-Library.SchLib
PCB/Altium Libraries/Imported PowerBoardLib1.PrjPcb/PowerBoardLib1.PCBLIB
PCB/Altium Libraries/Imported PowerBoardLib1.PrjPcb/PowerBoardLib1.PrjPcb
PCB/Altium Libraries/Imported PowerBoardLib1.PrjPcb/PowerBoardLib1.SCHLIB
PCB/MainBay_v2.1/MainBay_v2.1.PrjPCB
PCB/MainBay_v2.1/MainBayPCB_v2.1.PcbDoc
PCB/MainBay_v2.1/Top Sheet.SchDoc
PCB/MainBay_v2.2/MainBay_v2.2.PrjPCB
PCB/MainBay_v2.2/MainBay_v2.2_PCB.PcbDoc
PCB/MainBay_v2.2/Microcontroller.SchDoc
PCB/MainBay_v2.2/PowerSys.SchDoc
PCB/MainBay_v2.2/Sensors.SchDoc
PCB/PowerBoard_v1/main.SchDoc
PCB/PowerBoard_v1/PowerBoard_v1.PrjPCB
PCB/PowerBoard_v1/PowerPCB.PcbDoc
