JacksonRussett/UTAT_flightsystems/Radio/SV652_Radio_Connection/AccessPort137/AccessPort.ini

[Setting]
Language=English
[AccessPort]
SerialPort=12
BaudRate=9600
ParityBit=N
DataBit=8
StopBit=0
FlowControl=0
BufferSize=8192
SendCycle=1000
BytesPerLine=16
CopyHexDumpMode=0
SelectCharMode=0
MaxLogSize_MB=6
TextColor=0
BgColor=16777215
SysParameter=18369137
SendFile=
PredefDataFile=
AutoAckDataFile=
Font_Desc=-11:0:0:0:400:0:0:0:0:1:2:0:34
Font_Name=Lucida Sans Unicode
