JacksonRussett/UTAT_flightsystems/(commit log)

2019-06-23 Initial copying of all flight systems files to the new repo
    [20190312_AvionicsFramePlate (part) (dnp).SLDPRT, 20190312_RBFHolder (part) (dnp).SLDPRT, 20190312_Radio (rep) (dnp).SLDPRT, 20190316_StratoLoggers.SLDPRT, 20190330_AvionicsFrameBases (nrtp).SLDPRT, 20190330_BatteryCrib (nrtp).SLDPRT, 20190330_RadioMount (nrtp).SLDPRT, 20190406_AvionicsFrameBasesRBF (assembly) (dnp).SLDASM]
2019-06-23 Pushing more files to the new repo
    [503182-1852.PcbLib, 503182-1852.SchLib, ATMEGA2560-16AU.PcbLib, ATMEGA2560-16AU.SchLib, CAPAE430X550N.PcbLib, CAPAE430X550N.SchLib, CustomComp.PcbLib, CustomComp.SchLib]
2019-06-23 Moved some CAD files from Google Drive to the repo
    [20180727_Avionics_frame2.STL, 20190209_Avionics_Frame.SLDPRT, 20190312_AvionicsFramePlate (part) (dnp).SLDPRT, 20190312_RBFHolder (part) (dnp).SLDPRT, 20190312_Radio (rep) (dnp).SLDPRT, 20190316_StratoLoggers.SLDPRT, 20190330_AvionicsFrameBases (nrtp).SLDPRT, 20190330_BatteryCrib (nrtp).SLDPRT]
2019-06-28 Started a new power supply PCB project
    [503182-1852.PcbLib, 503182-1852.SchLib, ATMEGA2560-16AU.PcbLib, ATMEGA2560-16AU.SchLib, CAPAE430X550N.PcbLib, CAPAE430X550N.SchLib, Common-Parts-Library.PcbLib, Common-Parts-Library.SchLib]
2019-06-28 Modified the PCB library to include a 3.3V buck converter
    SC189ZSKTRT switching regulator - https://www.digikey.ca/product-detail/en/semtech-corporation/SC189ZSKTRT/SC189ZSKCT-ND/2182343
    [Common-Parts-Library.PcbLib, Common-Parts-Library.SchLib, main.SchDoc]
2019-06-28 Added the Flight Systems BOM
    [Flight Systems Bill of Materials.xlsx]
2019-07-01 Updated BOM
    [Flight Systems Bill of Materials.xlsx]
2019-07-01 Completed the initial draft of the Power PCB
    [1201M2S3AQE2.PcbLib, 1201M2S3AQE2.SchLib, Common-Parts-Library.PcbLib, Common-Parts-Library.SchLib, PowerBoardLib1.PCBLIB, PowerBoardLib1.PrjPcb, PowerBoardLib1.SCHLIB, PowerPCB.PcbDoc]
2019-07-04 Added RPi Camera Recording System files
2019-07-04 Power PCB Changes
    [main.SchDoc]
2019-07-05 More Power PCB Changes
    [PowerPCB.PcbDoc, main.SchDoc]
2019-07-05 Added current concepts for sensor testing board.
2019-07-06 Power PCB Layout Changes
    [PowerPCB.PcbDoc, main.SchDoc]
2019-07-08 Added some Test/Dev board design files
2019-07-08 Added old PCB block diagram
2019-07-10 Test board block diagram updates
2019-07-10 Updated .drawio file for Test Board
2019-07-16 Completed Power PCB
    [PowerPCB.PcbDoc, main.SchDoc]
2019-07-16 Updated completed Power PCB
    [PowerPCB.PcbDoc, main.SchDoc]
2019-07-30 Finished and ordered Power PCB
    [MainBay_v2.2_PCB.PcbDoc, PowerBoard_v1.PrjPCB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]
2019-08-01 Some Power PCB Fixes
    [Common-Parts-Library.PcbLib, Common-Parts-Library.SchLib, PowerPCB.PcbDoc]
2019-08-07 More Power PCB Changes before final order
    [PowerBoard_v1.PrjPCB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]
2019-10-07 Update after URRG Launches
    [20190504_L2_Avionics_Rails-p.sldprt, 20190506_L2_AvionicsFrameBasesRBF-p.sldprt, 20190506_L2_AvionicsFramePlate-p.sldprt, MainBay_v2.2_PCB.PcbDoc, PowerPCB.PcbDoc]
2019-11-07 Created document to keep track of EasyEDA PCBs
2019-11-08 Added updated version of complete L2 CAD
2019-11-10 Fixed SD card consecutive write issue
    [MS5611.cpp, MS5611.h, leanSD.cpp, leanSD.h, main.ino]
2019-11-14 Fixed GPS issue in flight code, added radio comms
    [L2_Nov2019.ino]
2019-11-16 Auto stash before merge of "master" and "origin/master"
    [test.csv]
